BEAMRobotics/ig_handle/ecad/teensy_4.1/ig_handle_teensy_4.1_pinout.pdf

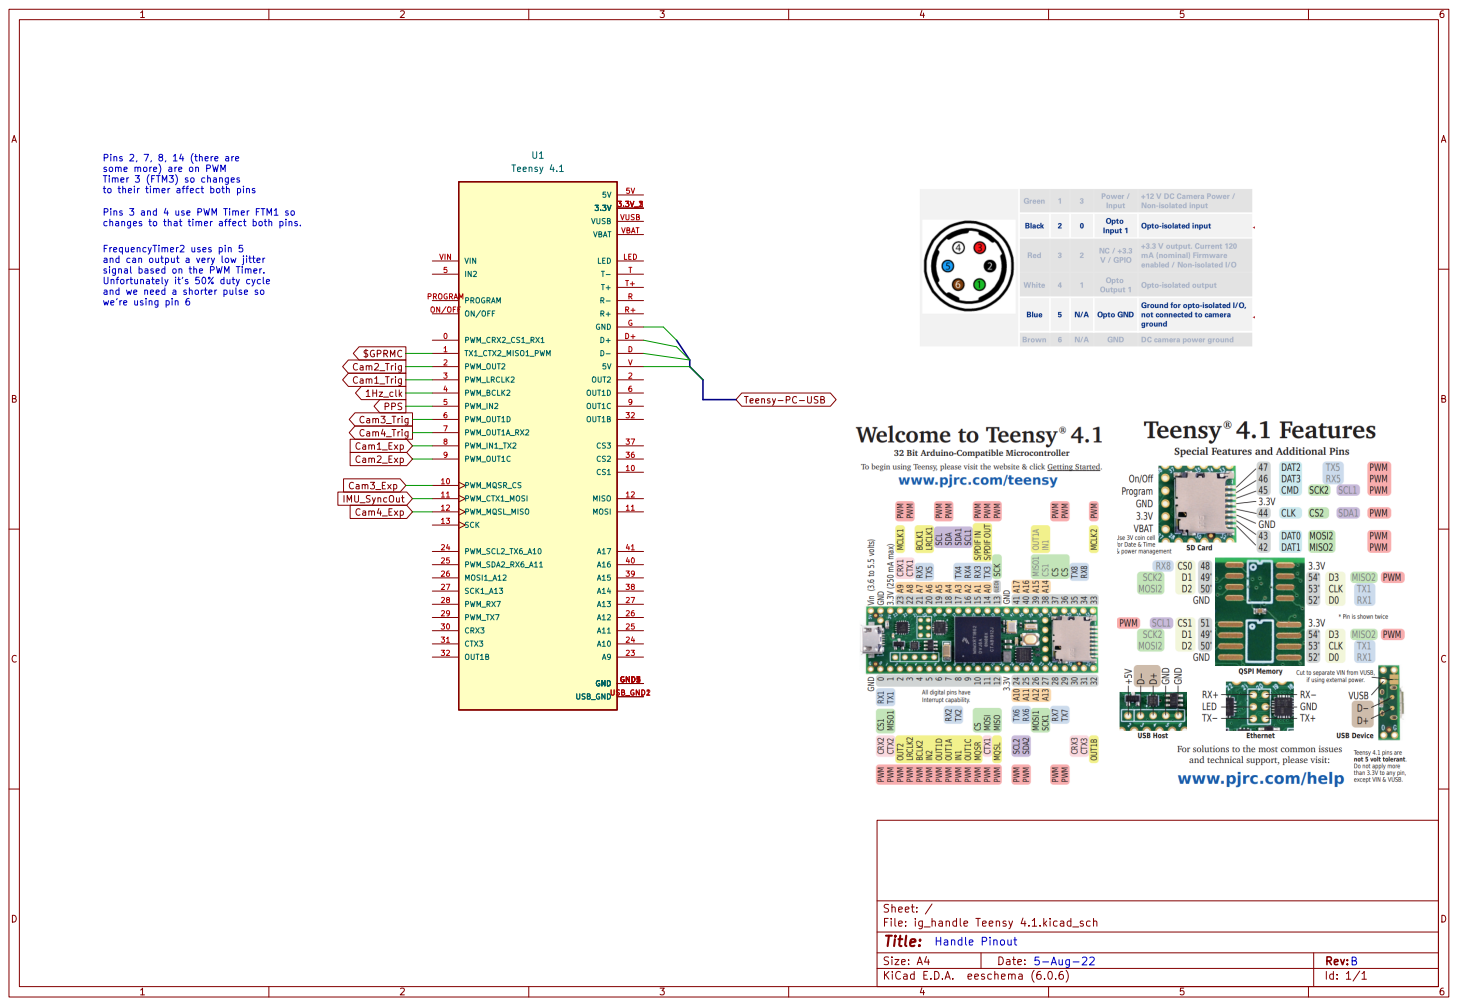
[picture p1: page 1]

Pins 2, 7, 8, 14 (there are
some more) are on PWM
Timer 3 (FTM3) so changes
to their timer affect both pins Pins 3 and 4 use PWM Timer FTM1 so

changes to that timer affect both pins.

FrequencyTimer2 uses pin 5
and can output a very low jitter
signal based on the PWM Timer.
and we need a shorter pulse so
