BEAMRobotics/ig_handle/ecad/teensy_3.6/ig_handle_teensy_3.6_pinout.pdf

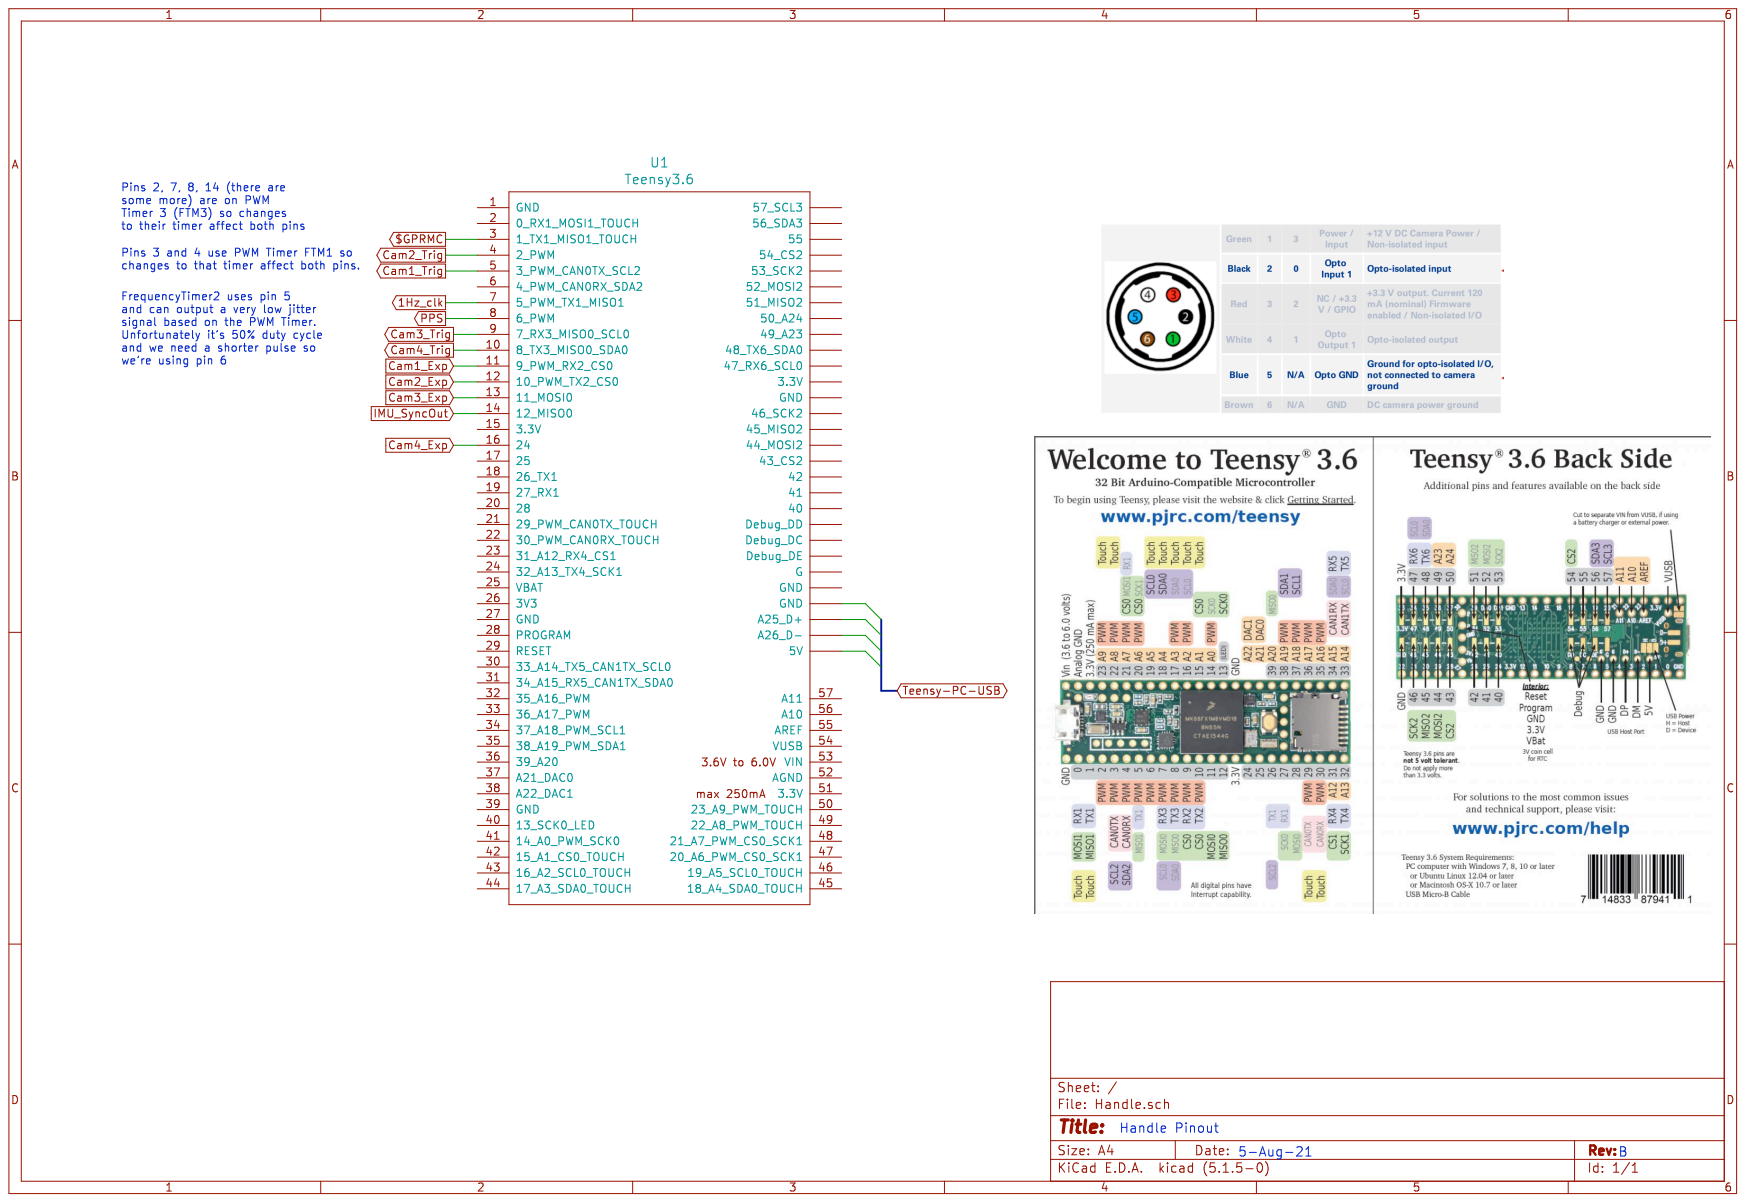
[picture p2: page 1]
