BEAMRobotics/ig_handle/docs/basic_wiring_schematic.pdf

# MICROCONTROLLER SCHEME

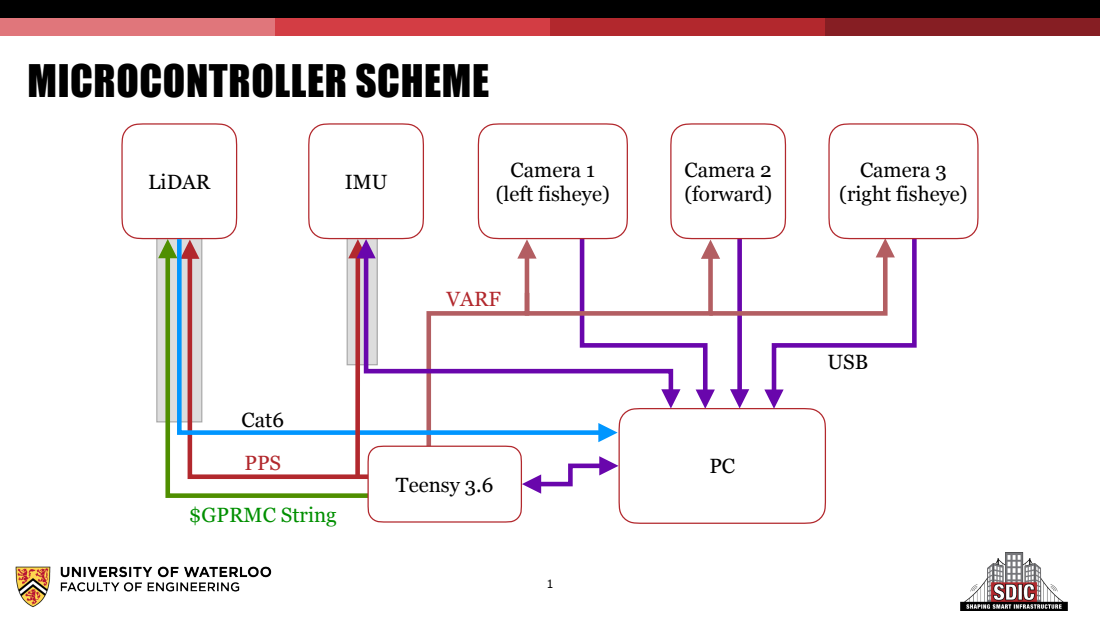
[picture p4: page 1]
Camera 1 (left fisheye); Camera 2 (forward) LiDAR; IMU; PPS; VARF; USB; Cat6; Teensy 3.6; $GPRMC String; Camera 3 (right fisheye)

# LIDAR

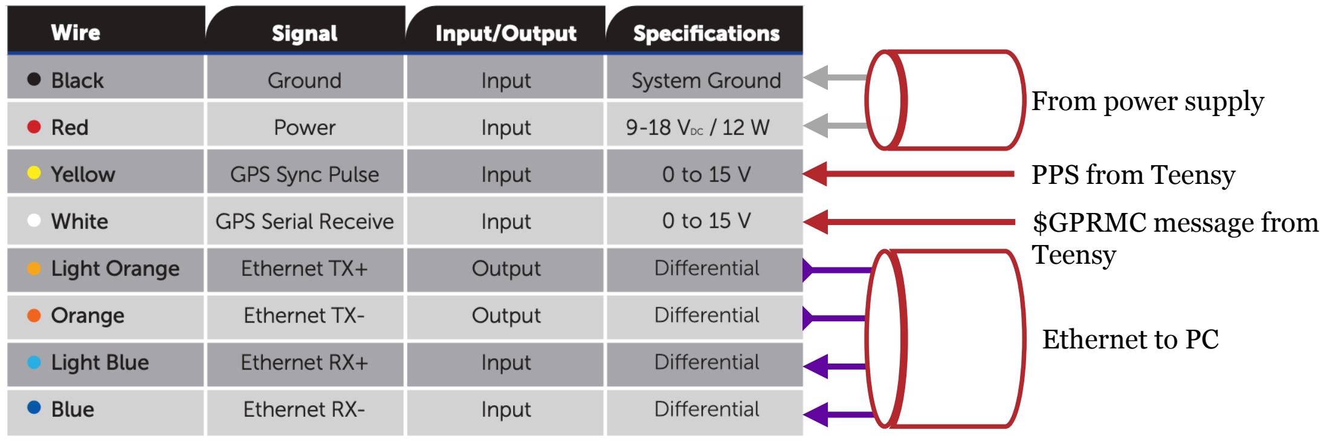
[picture p5: figure]
PPS from Teensy; $GPRMC message from Teensy; From power supply; Ethernet to PC

# IMU

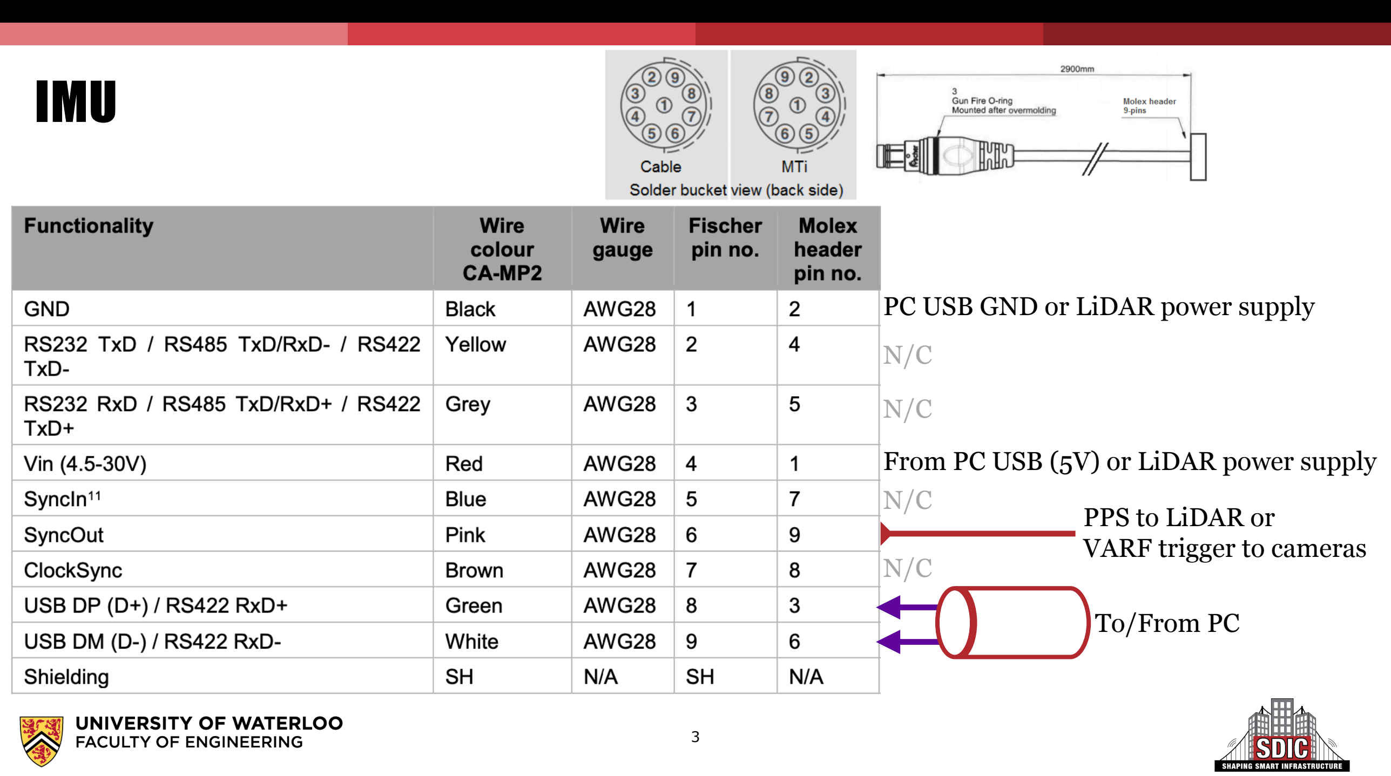
[picture p6: page 3]

To/From PC

N/C

N/C

N/C

N/C

From PC USB (5V) or LiDAR power supply

PPS to LiDAR or
VARF trigger to cameras

PC USB GND or LiDAR power supply

# CAMERAS

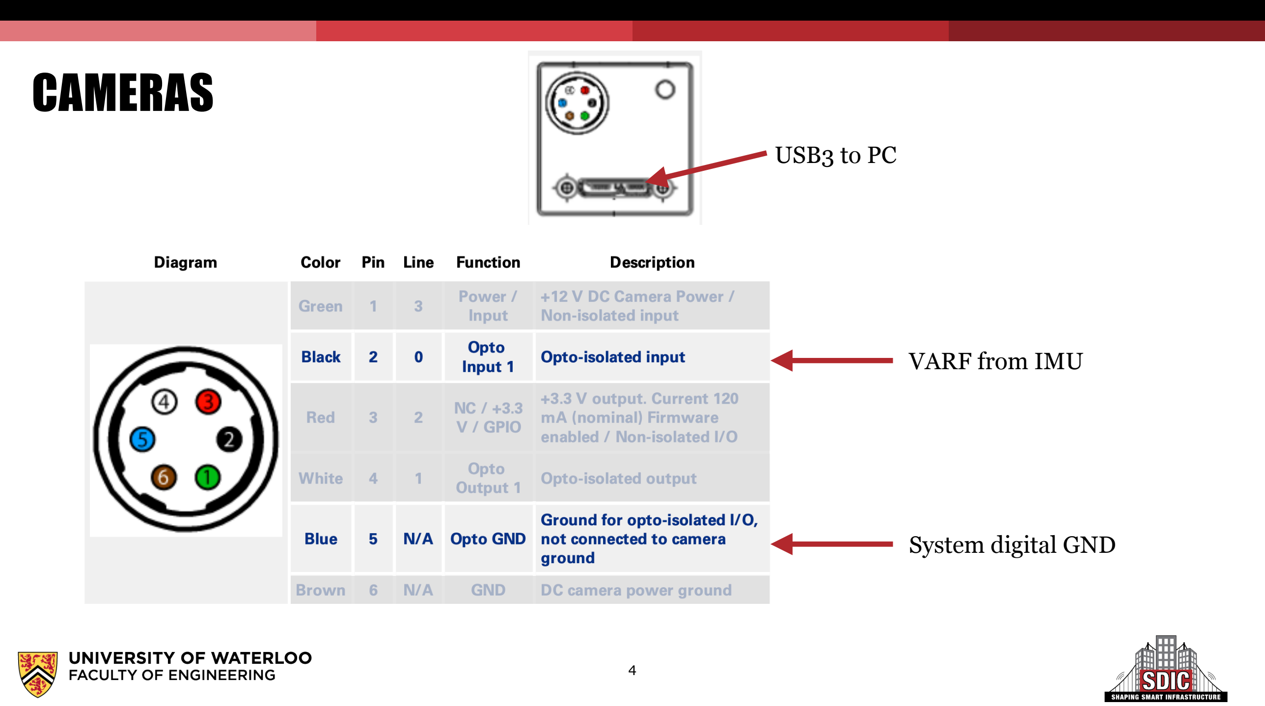
[picture p7: page 4]

VARF from IMU

System digital GND

USB3 to PC
