BEAMRobotics/ig_handle/(threads)

Thread 19 (2022-09-13):

Update for stereo vision

adthoms, 2022-09-13:
`FrequencyTimer2.h` is no longer supported by teensy 4 and an alternative solution needs to be developed in order to maintain the same level of functionality. Main.ino also has to be updated for stereo vision.

Edit: IntervalTimer should replace FrequencyTimer2.h

Edit: `main.ino` should be updated to synchronize capture between both cameras. See this [guide](https://www.flir.com/support-center/iis/machine-vision/application-note/configuring-synchronized-capture-with-multiple-cameras/) and work towards integrating the teensy with this solution

Edit: remove `manual_installation.md` as this is now included in the beam_robotics install.

Edit: Please keep all cameras functional. In the previous build, this did not cause an issue when using less than four cameras.

Closed 2023-08-04.
