BEAMRobotics/ig_handle/teensy/main/main.ino

#include <ros.h>
#include <sensor_msgs/TimeReference.h>
#include <TimeLib.h>

#define USE_USBCON

// Electrical component pin numbers
#define GPSERIAL Serial1 // $GPRMC
#define PPS_PIN 7   // PPS
#define IMU_IN 8    // IMU_SyncIn
#define CAM1_OUT 3  // Cam1_Trig
#define CAM2_OUT 4  // Cam2_Trig
#define CAM3_OUT 11 // Cam3_Trig
#define CAM4_OUT 10 // Cam4_Trig
#define CAM1_IN 5   // Cam1_Exp
#define CAM2_IN 6   // Cam2_Exp
#define CAM3_IN 27  // Cam3_Exp
#define CAM4_IN 24  // Cam4_Exp
#define IMU_START 9 // IMU_SyncOut

// ROS node handler
ros::NodeHandle nh;

// Trigger variables for camera and imu
sensor_msgs::TimeReference time_msg;
ros::Publisher F1_time("/F1/cam_time", &time_msg);
ros::Publisher F2_time("/F2/cam_time", &time_msg);
ros::Publisher F3_time("/F3/cam_time", &time_msg);
ros::Publisher F4_time("/F4/cam_time", &time_msg);
ros::Publisher IMU_time("/imu/imu_time", &time_msg);
IntervalTimer teensy_clock;
ros::Time F1_close_stamp, F2_close_stamp, F3_close_stamp, F4_close_stamp, IMU_stamp;
volatile bool sendNMEA = false, F1_closed = false, F2_closed = false,
              F3_closed = false, F4_closed = false, IMU_sampled = false; 

// Forward function declarations
void cam1_ISR(void);
void cam2_ISR(void);
void cam3_ISR(void);
void cam4_ISR(void);
void IMU_ISR(void);
void setSendNMEA(void);
void enableTriggers();
String checksum(String msg);

// Booleans to ensure synchronized camera capture
bool cam1_capture = false;
bool cam2_capture = false;
bool cam3_capture = false;
bool cam4_capture = false;

/*
 * Initial setup for the arduino sketch
 * This function performs:
 *  - Configure timers for LiDAR and camera triggering
 *  - Advertisement and subscribing to ROS topics
 *  - UART Serial setup for NMEA strings
 *  - Holds until rosserial is connected
 */
void setup() {  
  /* Setup outputs to LiDAR
   *  - PPS but don't start it yet
   *  - Attach
   */
  pinMode(PPS_PIN, OUTPUT);  // 50% duty cycle
  
  // begin clock
  teensy_clock.begin(setSendNMEA_ISR,1000000); // call setSendNMEA_ISR every 10^6 microseconds
    
  // node initialization
  nh.initNode();
  nh.advertise(F1_time);
  nh.advertise(F2_time);
  nh.advertise(F3_time);
  nh.advertise(F4_time);
  nh.advertise(IMU_time);

  // configure input pins
  pinMode(CAM1_IN, INPUT_PULLDOWN);
  pinMode(CAM2_IN, INPUT_PULLDOWN);
  pinMode(CAM3_IN, INPUT_PULLDOWN);
  pinMode(CAM4_IN, INPUT_PULLDOWN);
  pinMode(IMU_IN, INPUT_PULLUP);

  // enable interrupts
  attachInterrupt(digitalPinToInterrupt(CAM1_IN), cam1_ISR, RISING);
  attachInterrupt(digitalPinToInterrupt(CAM2_IN), cam2_ISR, RISING);
  attachInterrupt(digitalPinToInterrupt(CAM3_IN), cam3_ISR, RISING);
  attachInterrupt(digitalPinToInterrupt(CAM4_IN), cam4_ISR, RISING);
  attachInterrupt(digitalPinToInterrupt(IMU_IN), IMU_ISR, RISING);

  // set up the camera triggers but don't start them yet either
  analogWriteFrequency(CAM1_OUT, 20.0);  // 20.0 Hz base frequency for the PWM signal
  analogWriteFrequency(CAM2_OUT, 20.0);  // We're using a PWM signal because it's a way of offloading
  analogWriteFrequency(CAM3_OUT, 20.0);  // the task to free up the main loop
  analogWriteFrequency(CAM4_OUT, 20.0);
  
  // setup IMU_START ping as output
  pinMode(IMU_START, OUTPUT);
  digitalWrite(IMU_START, LOW); // make sure that the pin is low before we send a rising edge
  
  // nh.loginfo(nmea_string.c_str());

  // await nodehandle time sync
  while (!nh.connected()) {
    nh.spinOnce(); 
  }
  nh.loginfo("Setup complete.");
  
  // start sampling
  enableTriggers();
}

/*
 * Continously looping function performs the following:
 *  - Triggering camera line at certain frequency and publishes the timestamp to
 * /cam_time
 *  - Trigger lidar line (PPS) and transmits NMEA string over Serial1
 */
void loop() {
  if (sendNMEA == true) {
    char time_now[7], date_now[7];
    time_t t = nh.now().sec;
    sprintf(time_now, "%02i%02i%02i", hour(t), minute(t), second(t));
    sprintf(date_now, "%02i%02i%02i", day(t), month(t), year(t) % 100);
    String nmea_string = F("GPRMC,") + String(time_now) +
                         F(",A,4365.107,N,79347.702,E,022.4,084.4,") +
                         String(date_now) + ",003.1,W";
    String chk = checksum(nmea_string);
    nmea_string = "$" + nmea_string + "*" + chk + "\n";
    GPSERIAL.print(nmea_string);
    sendNMEA = false;
    digitalWriteFast(PPS_PIN, LOW);  // minimum pulse duration required by LiDAR is 10 us    
  }
  
  if (F1_closed == true) {
    F1_closed = false;
    time_msg.time_ref = F1_close_stamp;
    F1_time.publish(&time_msg);
  }
  if (F2_closed == true) {
    F2_closed = false;
    time_msg.time_ref = F2_close_stamp;
    F2_time.publish(&time_msg);
  }
  if (F3_closed == true) {
    F3_closed = false;
    time_msg.time_ref = F3_close_stamp;
    F3_time.publish(&time_msg);
  }
  if (F4_closed == true) {
    F4_closed = false;
    time_msg.time_ref = F4_close_stamp;
    F4_time.publish(&time_msg);
  }
  if (IMU_sampled == true) {
    IMU_sampled = false;
    time_msg.time_ref = IMU_stamp;
    IMU_time.publish(&time_msg);
  }

  nh.spinOnce();
}

/***********************************************
 *            Helper functions                 *
 ***********************************************/

// Send NMEA interrupt
void setSendNMEA_ISR(void) {
  /* It's not really recommended to write to pins from an interrupt as it can
   * take a relatively long time to execute. However, one of the main purposes
   * of this code is to output accurate PPS signal and this is the most accurate
   * way that abides by the format constraints on the signal.
   */
  digitalWriteFast(PPS_PIN, HIGH);
  sendNMEA = true;
}

// Timestamp creation interrupts
void cam1_ISR(void) {  
  if (digitalRead(CAM1_IN) && !cam1_capture)
  {
    F1_close_stamp = nh.now();
    F1_closed = true; 
    cam1_capture = true;  
  }
  else
  {
    cam1_capture = false; 
  }
}

void cam2_ISR(void) {
  if (digitalRead(CAM2_IN) && !cam2_capture)
  {
    F2_close_stamp = nh.now();
    F2_closed = true; 
    cam2_capture = true;   
  }
  else
  {
    cam2_capture = false;
  }  
}

void cam3_ISR(void) {
  if(digitalRead(CAM3_IN) && !cam3_capture)
  {
    F3_close_stamp = nh.now();
    F3_closed = true;
    cam3_capture = true;
  }
  else
  {
    cam3_capture = false;
  } 
}

void cam4_ISR(void) {
  if(digitalRead(CAM4_IN) && !cam4_capture)
  {
    F4_close_stamp = nh.now();
    F4_closed = true;
    cam4_capture = true;
  }
  else
  {
    cam4_capture = false;
  }  
}

void IMU_ISR(void) {
  IMU_stamp = nh.now();
  IMU_sampled = true;
}

// Computes XOR checksum of NMEA sentence
String checksum(String msg) {
  byte chksum = 0;
  int l = msg.length();
  for (int i = 0; i < l; i++) {
    chksum ^= msg[i];
  }
  
  String result = String(chksum, HEX);
  result.toUpperCase();
  if (result.length() < 2) {
    result = "0" + result;
  }
  return result;
}

void enableTriggers() {
  nh.loginfo("Enabling triggers.");
  analogWrite(CAM1_OUT, 5);  // 5% duty cycle @ 20 Hz = 2.5 ms pulse
  analogWrite(CAM2_OUT, 5);
  analogWrite(CAM3_OUT, 5);
  analogWrite(CAM4_OUT, 5);
  digitalWrite(IMU_START, HIGH);
  nh.loginfo("Triggers enabled.");
}
