BEAMRobotics/ig_handle/(commit log)

2019-07-18 remove IMU and add multi cam functionality
2021-02-13 Started redesigning camera triggering
    [main.ino]
2021-02-17 Documented pins for tirggering
    [Handle.sch]
2021-02-19 Camera and IMU interrupts/messages written but not debugged.
2021-02-25 sonar_virtual_machine node
2021-02-26 Tested rosserial messaging and the Teensy is sending timestamp messages based on interrupts. Timestamps are time since Teensy startup.
2021-04-21 attach interrupt for IMU
2021-04-21 attach interrupt IMU
2021-04-27 Fix sub-second and second alignment
    [main.ino]
2021-04-29 Fix sub second portion of message stamp
    Camera and IMU timestamp message nsec portion was actually sending microseconds and has been updated to nanoseconds.
    [main.ino]
2021-05-12 multi-sensor sync improvements
2021-08-04 Possible fix for timestamp errors
    Seemed to be a wraparound error on IMU and Camera timestamp publishing. Switched to micros() instead of ellapsedmicros() in the ISRs. Also fixed an error with converting us to ns in the timestamp message.
    [main.ino]
2021-08-05 Added pinouts for a 4th camera
    [Handle.sch]
2021-08-05 Add triggering for 4th camera
2021-08-06 clean/add IMU
2021-08-06 imu stamp sync node+nodelet
2021-08-06 restamp_nodelet templating for use with cameras
2021-08-06 imu param fixes
2021-08-06 multi-cam/lidar launch files
2021-08-06 multi-camera debugging
2021-08-06 multi-camera support
2021-08-06 3cams/imu/lidar scanning
2021-08-06 dual lidar launching
2021-08-06 arduino time sync action server
2021-08-09 launch/config for calibration data collection
2021-08-12 calibration data prep
2021-08-23 remove toggling/add IMU start
2021-08-23 extrinsic calibration data recording
2021-09-01 swap lidars and terminator launch update
2021-09-01 swap lidars
2021-09-01 swap lidars bugfix
2021-09-22 udev rules to nickname imu/teensy ports
2021-09-22 throttle default false :
2021-10-06 Updated schematic to show the changed pinout that enables one more frequent camera and 3 slower cameras.
    [Handle.sch]
2021-10-06 Added image of T3.6 physical pins.
    [Handle.sch]
2021-11-09 add additional IP for sonar to netplan
2021-11-09 add sonar IP to netplan
2022-01-04 update stamping of non image or imu messages
    This script current copies all messages into a new bag based on header time, instead of index time.
    This is fine for messages that we are restamping, because that'll make them playback in more 'real-time'
    However, we can't do this for all message types, because some message types don't actually have a header.
    I ran into this problem with the vicon bags, because they have some messages that don't contain a header so this script crashes. This fix solved that.
2022-07-14 remove deprecated sonar files
2022-07-14 Add handle ecad (#5)
    * add ecad documentation to README.md
    * rename ecad files
    [ig_handle.kicad_pcb, ig_handle.sch]
2022-07-24 Add documentation (#9)
    * add initial documentation
    * rename parts list
    [parts_list.csv]
2022-08-06 fix lidar launch for ros-drivers/velodyne (#12)
2022-08-09 Add files via upload
    Added ecad drawings they have been reviewed and approved by Dirk
    [ig_handle Teensy 4.1.kicad_sch]
2022-08-10 reorganize ecad files (#16)
    * reorganize ecad files
    * fix formatting and address PR comments
    [ig_handle_teensy_3.6.kicad_pcb, ig_handle_teensy_3.6.sch, ig_handle_teensy_4.1.kicad_sch]
2022-08-11 add lidar ports (#17)
2022-10-02 update camera launch files (#20)
